Sharp-02/Full-Auto-Nerf-MA40/MA40_Schematic.png

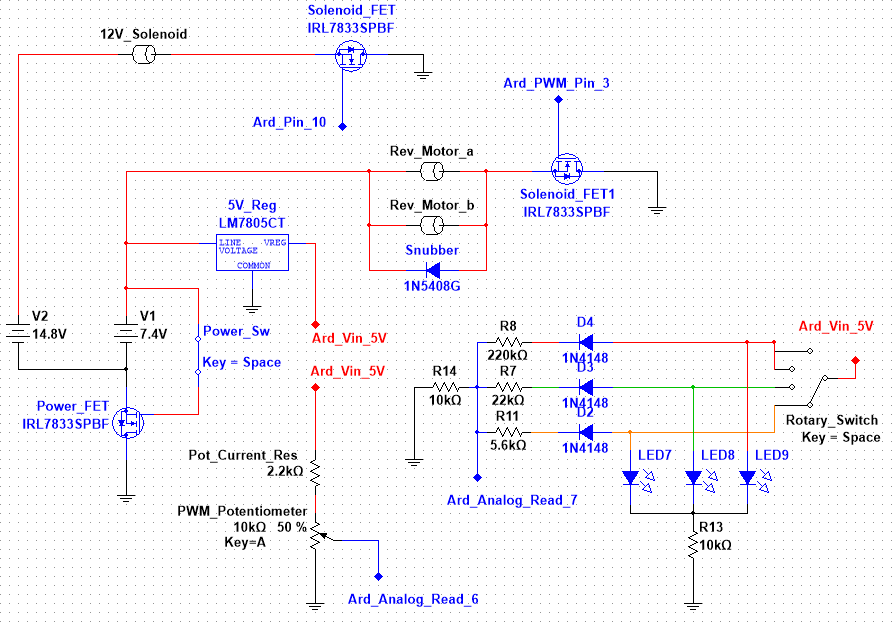
MA40_Schematic.png
